sds1979v/NES4miniNES/README.md

NES4miniNES

Use an ATmega328 to turn an old 80's NES controller to a new shiny (and almost original) mini NES controller

//2017.12.08
added INSTRUCTIONS...
